greyboxaudio/Purrtico-M/README.md

# Purrtico-M
 
Based on the AMEK MZ-15-RN Equalizer
