greyboxaudio/Purrtico-M/Purrtico_M.pdf

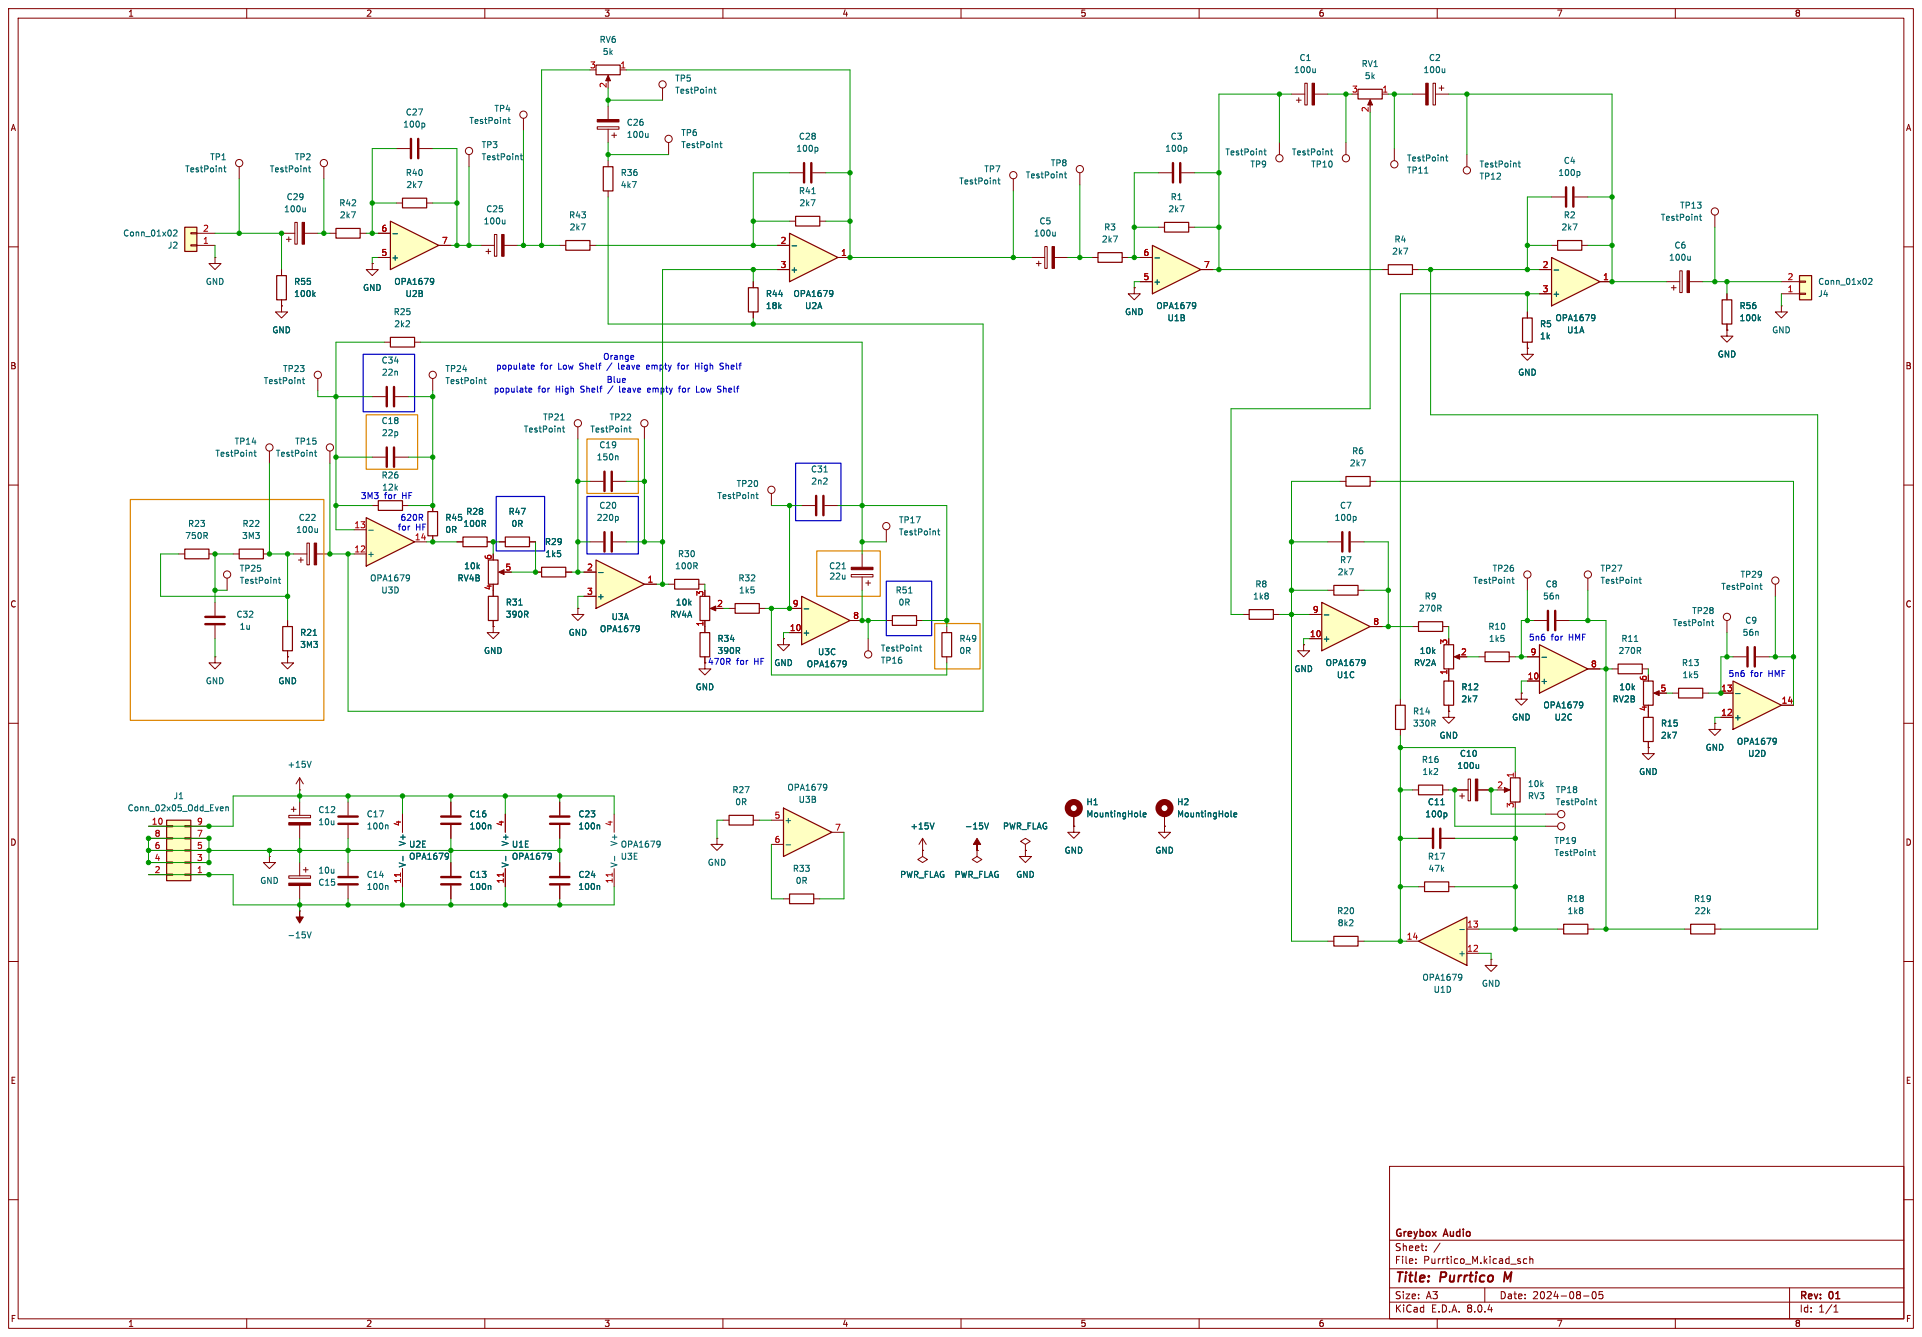
[picture p1: page 1]
