greyboxaudio/Purrtico-M/Simulation/purrtico_m.asc

C1: cap; 100p
C2: cap; 100µ
C3: cap; 100µ
C4: cap; 5n6
C5: cap; 5n6
C6: cap; 150n
C7: cap; 22p
C8: cap; 1µ
C9: polcap; 22µ; V=16 Irms=2.88675 Rser=0.03 Lser=0 mfg="KEMET" pn="A700D226M016ATE030" type="Al electrolytic"
C10: cap; 100p
C11: cap; 100p
C12: polcap; 100µ; V=25 Irms=110m Rser=0.5543 Lser=3.868n mfg="Würth Elektronik" pn="865090449009 WCAP-ASLU 8x6,5" type="Al electrolytic"
C13: polcap; 100µ; V=25 Irms=110m Rser=0.5543 Lser=3.868n mfg="Würth Elektronik" pn="865090449009 WCAP-ASLU 8x6,5" type="Al electrolytic"
C14: polcap; 100µ; V=25 Irms=110m Rser=0.5543 Lser=3.868n mfg="Würth Elektronik" pn="865090449009 WCAP-ASLU 8x6,5" type="Al electrolytic"
C15: polcap; 100µ; V=25 Irms=110m Rser=0.5543 Lser=3.868n mfg="Würth Elektronik" pn="865090449009 WCAP-ASLU 8x6,5" type="Al electrolytic"
C16: polcap; 100µ; V=25 Irms=110m Rser=0.5543 Lser=3.868n mfg="Würth Elektronik" pn="865090449009 WCAP-ASLU 8x6,5" type="Al electrolytic"
C17: polcap; 100µ; V=35 Irms=414m Rser=0.18 Lser=3.3n mfg="Würth Elektronik" pn="860160574013 WCAP-ATLL 8x11,5" type="Al electrolytic"
C18: cap; 100p
C19: cap; 100p
C20: cap; 220p
C21: cap; 22n
C22: cap; 100p
C23: cap; 100p
C24: cap; 100µ
C25: cap; 100µ
C26: cap; 100p
C27: cap; 100p
C28: cap; 100µ
C29: cap; 100µ
C30: cap; 56n
C31: cap; 56n
C32: cap; 100p
C33: cap; 100p
C34: cap; 100µ
C35: cap; 100µ
C36: cap; 100p
C67: cap; 2n2
C68: polcap; 100µ; V=35 Irms=414m Rser=0.18 Lser=3.3n mfg="Würth Elektronik" pn="860160574013 WCAP-ATLL 8x11,5" type="Al electrolytic"
C69: polcap; 100µ; V=35 Irms=414m Rser=0.18 Lser=3.3n mfg="Würth Elektronik" pn="860160574013 WCAP-ATLL 8x11,5" type="Al electrolytic"
C70: polcap; 100µ; V=35 Irms=414m Rser=0.18 Lser=3.3n mfg="Würth Elektronik" pn="860160574013 WCAP-ATLL 8x11,5" type="Al electrolytic"
R1: res; 2k7
R2: res; 2k7
R3: res; 1k8
R4: res; 1k
R5: res; 270
R6: res; 1k5
R7: res; 1k5
R8: res; 2k2
R9: res; 12k
R10: res; 2k7
R11: res; 2k7
R12: res; 100
R13: res; 2k7
R14: res; 1k5
R15: res; 100
R16: res; 390
R17: res; 1k5
R18: res; 390
R19: res; 3Meg3
R20: res; 750
R21: res; 3Meg3
R22: res; 2k7
R23: res; 2k7
R24: res; 2k7
R25: res; 2k7
R26: res; 4k7
R27: res; 18k
R28: res; 2k7
R29: res; 2k7
R30: res; 47k
R31: res; 1k8
R32: res; 8k2
R33: res; 22k
R34: res; 2k7
R35: res; 1k8
R36: res; 1k
R37: res; 1k5
R38: res; 2k7
R39: res; 1k5
R40: res; 2k7
R41: res; 47k
R42: res; 1k8
R43: res; 8k2
R44: res; 22k
R45: res; 1k2
R46: res; 330
R47: res; 2k7
R48: res; 2k7
R49: res; 270
R50: res; 270
R51: res; 2k7
R52: res; 2k7
R74: res; 1k2
R75: res; 330
R76: res; 2k7
R77: res; 2k7
R78: res; 270
R115: res; 2k7
R116: res; 2k7
R117: res; 2k7
R118: res; 2k7
R119: res; 4k7
R120: res; 18k
R121: res; 1k5
R122: res; 2k2
R123: res; 3Meg3
R124: res; 100
R125: res; 100
R126: res; 1k5
R127: res; 470
R128: res; 620
U1: ADTL082
U4: ADTL082
U9: ADTL082
U10: ADTL082
U11: ADTL082
U12: ADTL082
U13: ADTL082
U14: ADTL082
U15: ADTL082
U16: ADTL082
U17: ADTL082
U18: ADTL082
U19: ADTL082
U20: ADTL082
U21: ADTL082
U22: ADTL082
U23: ADTL082
U32: ADTL082
U33: ADTL082
U34: ADTL082
U35: ADTL082
U36: ADTL082
V1: voltage; 15
V2: voltage; -15
V3: voltage; SINE(0 1 1000 0 0 0 1000); AC 1
VR1: res; {G1}
VR2: res; {G2}
VR3: res; {M1F1}
VR4: res; {M1F2}
VR5: res; {M1F1}
VR6: res; {M1F2}
VR7: res; {G1}
VR8: res; {G2}
VR9: res; {M2F1}
VR10: res; {Q1}
VR11: res; {M2F2}
VR12: res; {M2F1}
VR13: res; {M2F2}
VR14: res; {Q1}
VR15: res; {Q2}
VR16: res; {G2}
VR17: res; {G1}
VR18: res; {LFF1}
VR19: res; {LFF2}
VR20: res; {LFF1}
VR21: res; {LFF2}
VR22: res; {Q2}
VR31: res; {HFF1}
VR32: res; {HFF2}
VR33: res; {HFF1}
VR34: res; {HFF2}
VR35: res; {G1}
VR36: res; {G2}
Named nets: 0, V+, V-, HF, LF2, HMF, LMF2
.param G1=5k G2=1
.ac dec 101 10 100k
.step param Rx1 list 1 2
.param HFF1 table(Rx1,1,10k,2,1)
.param HFF2=table(Rx1,1,1,2,10k)
.param M1F1 table(Rx1,1,10k,2,1)
.param M1F2=table(Rx1,1,1,2,10k)
.param M2F1 table(Rx1,1,10k,2,1)
.param M2F2=table(Rx1,1,1,2,10k)
.param LFF1 table(Rx1,1,10k,2,1)
.param LFF2=table(Rx1,1,1,2,10k)
.param Q1=5k Q2=5k
