greyboxaudio/Purrtico-M/Purrtico_M.kicad_pcb

## KiCad design Purrtico_M.kicad_pcb (2024-08-16)

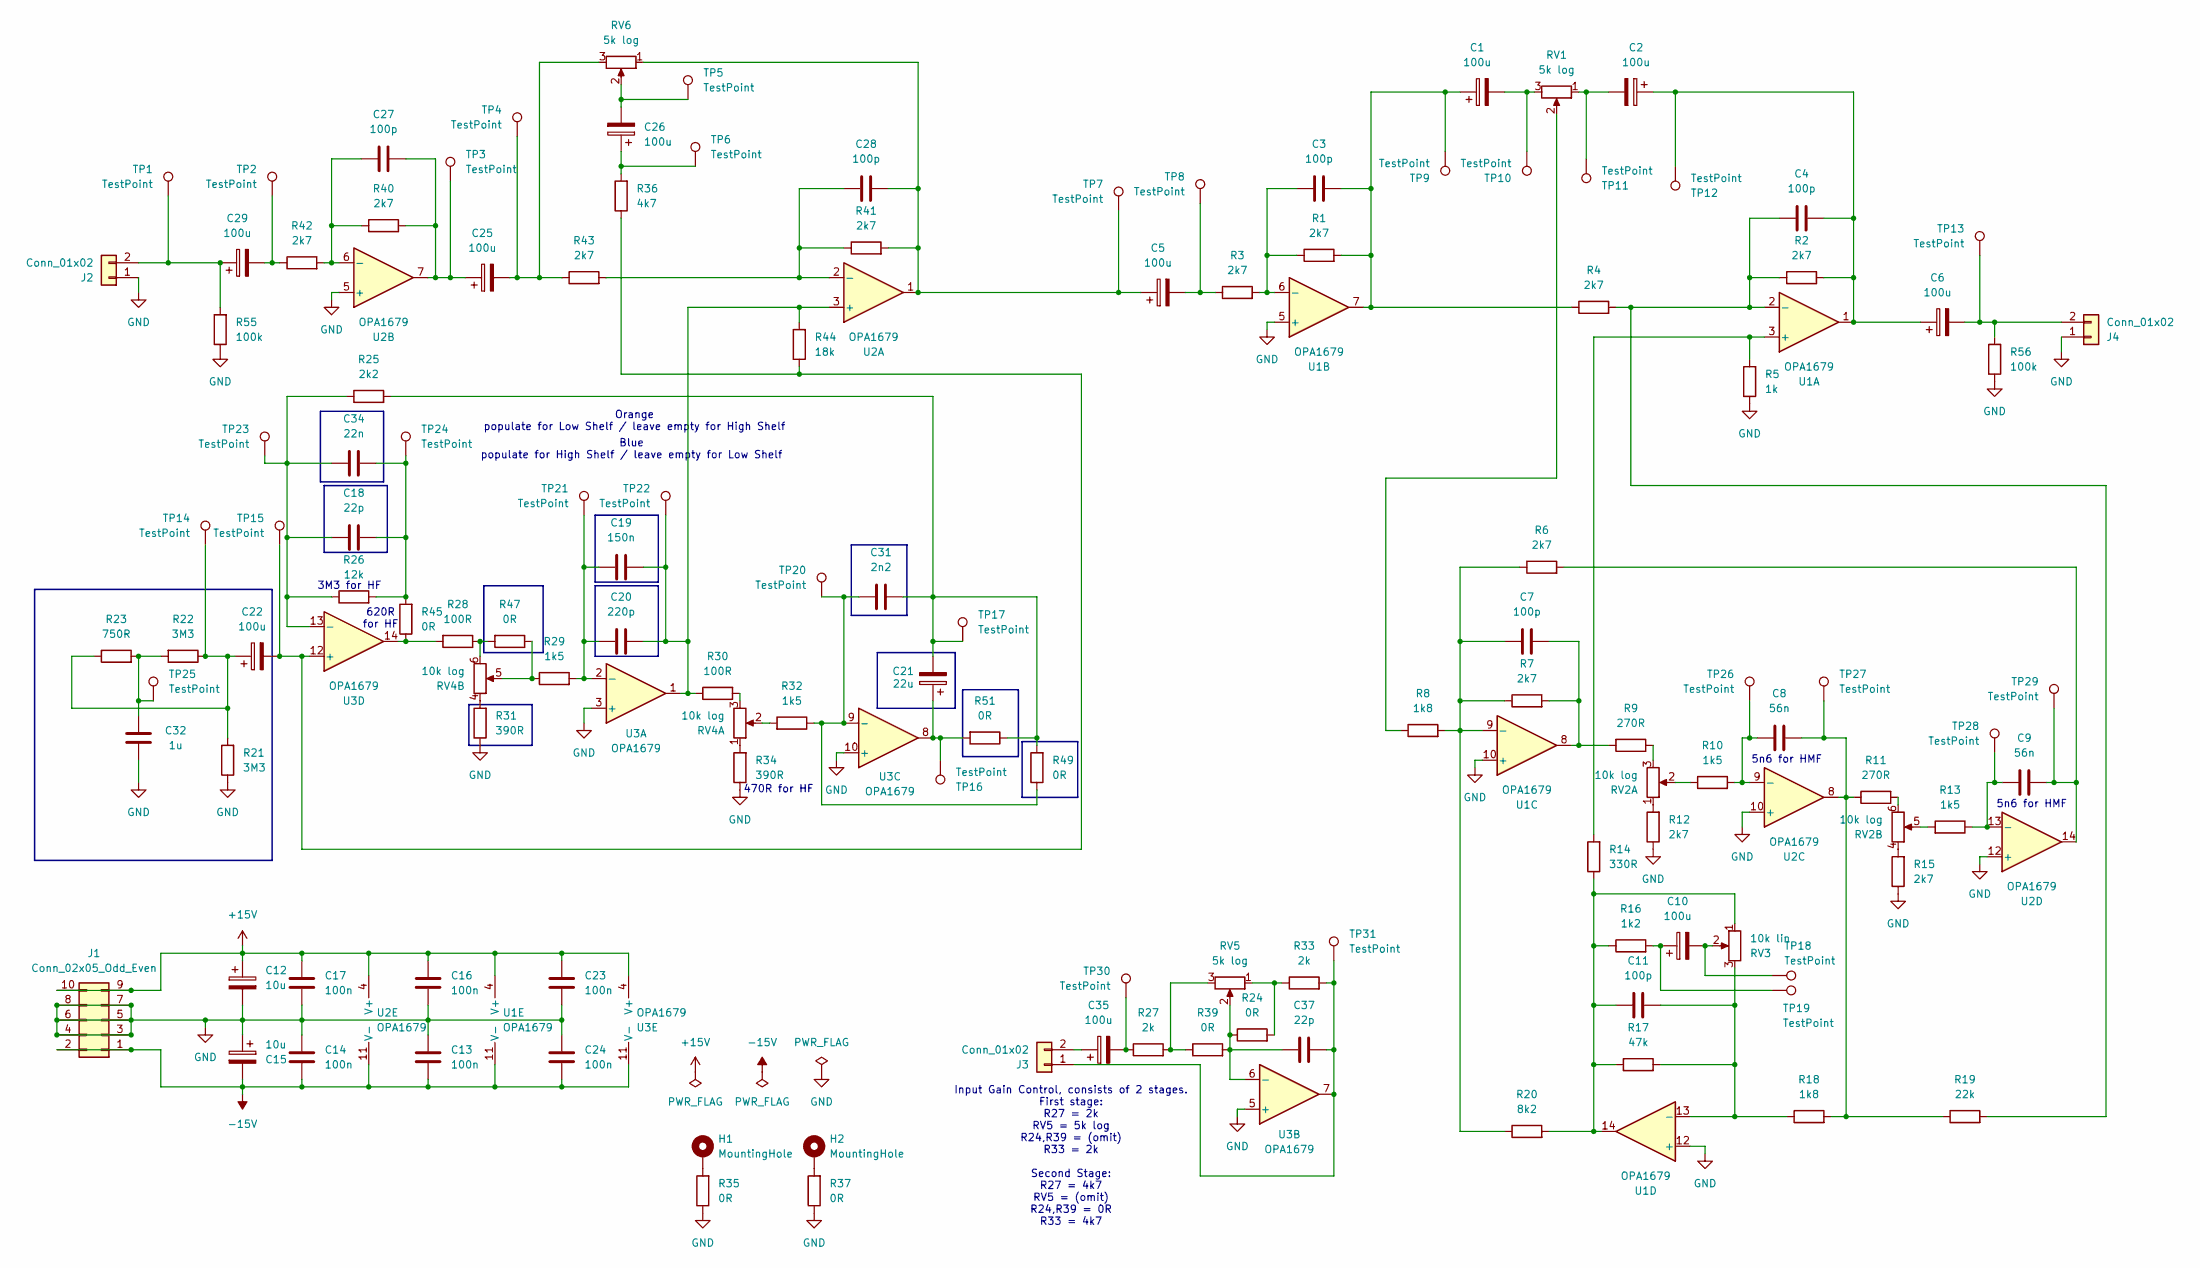
[picture p2: schematic Purrtico_M.kicad_sch, Purrtico M]

Parts:
C1, C2, C5, C6, C10, C22, C25, C26, C29, C35: 100u; CP_Radial_D6.3mm_P2.50mm
C3, C4, C7, C11, C27, C28: 100p; C_1206_3216Metric
C8, C9: 56n; C_Rect_L7.2mm_W2.5mm_P5.00mm_FKS2_FKP2_MKS2_MKP2
C12, C15: 10u; CP_Radial_D6.3mm_P2.50mm
C13, C14, C16, C17, C23, C24: 100n; C_1206_3216Metric
C18, C37: 22p; C_1206_3216Metric
C19: 150n; C_Rect_L7.2mm_W2.5mm_P5.00mm_FKS2_FKP2_MKS2_MKP2
C20: 220p; C_1206_3216Metric
C21: 22u; CP_Radial_D6.3mm_P2.50mm
C31: 2n2; C_Rect_L7.2mm_W2.5mm_P5.00mm_FKS2_FKP2_MKS2_MKP2
C32: 1u; C_Rect_L7.2mm_W2.5mm_P5.00mm_FKS2_FKP2_MKS2_MKP2
C34: 22n; C_Rect_L7.2mm_W2.5mm_P5.00mm_FKS2_FKP2_MKS2_MKP2
H1, H2: MountingHole; MountingHole_3.2mm_M3_DIN965_Pad
J1: Conn_02x05_Odd_Even; PinHeader_2x05_P2.54mm_Vertical
J2, J3, J4: Conn_01x02; PinHeader_1x02_P2.54mm_Vertical
R1, R2, R3, R4, R6, R7, R12, R15, R40, R41, R42, R43: 2k7; R_1206_3216Metric
R5: 1k; R_1206_3216Metric
R8, R18: 1k8; R_1206_3216Metric
R9, R11: 270R; R_1206_3216Metric
R10, R13, R29, R32: 1k5; R_1206_3216Metric
R14: 330R; R_1206_3216Metric
R16: 1k2; R_1206_3216Metric
R17: 47k; R_1206_3216Metric
R19: 22k; R_1206_3216Metric
R20: 8k2; R_1206_3216Metric
R21, R22: 3M3; R_1206_3216Metric
R23: 750R; R_1206_3216Metric
R24, R35, R37, R39, R45, R47, R49, R51: 0R; R_1206_3216Metric
R25: 2k2; R_1206_3216Metric
R26: 12k; R_1206_3216Metric
R27, R33: 2k; R_1206_3216Metric
R28, R30: 100R; R_1206_3216Metric
R31, R34: 390R; R_1206_3216Metric
R36: 4k7; R_1206_3216Metric
R44: 18k; R_1206_3216Metric
R55, R56: 100k; R_1206_3216Metric
RV1, RV5, RV6: 5k log; PinHeader_1x03_P2.54mm_Vertical
RV2, RV4: 10k log; PinHeader_2x03_P2.54mm_Vertical
RV3: 10k lin; PinHeader_1x03_P2.54mm_Vertical
TP1, TP2, TP3, TP4, TP5, TP6, TP7, TP8, TP9, TP10, TP11, TP12, TP13, TP14, TP15, TP16, TP17, TP18, TP19, TP20, TP21, TP22, TP23, TP24, TP25, TP26, TP27, TP28, TP29, TP30, TP31: TestPoint; TestPoint_THTPad_D1.0mm_Drill0.5mm
U1, U2, U3: OPA1679; SOIC-14_3.9x8.7mm_P1.27mm

Connections:
+15V: C12.1, C16.2, C17.2, C23.2, J1.9, J1.10, U1.4 (V+), U2.4 (V+), U3.4 (V+)
-15V: C13.1, C14.1, C15.2, C24.1, J1.1, J1.2, U1.11 (V-), U2.11 (V-), U3.11 (V-)
GND: C12.2, C13.2, C14.2, C15.1, C16.1, C17.1, C23.1, C24.2, C32.2, J1.3, J1.4, J1.5, J1.6, J1.7, J1.8, J2.1, J4.1, R5.1, R12.1, R15.1, R21.1, R31.1, R34.1, R35.1, R37.1, R55.1, R56.1, U1.5 (+), U1.10 (+), U1.12 (+), U2.5 (+), U2.10 (+), U2.12 (+), U3.3 (+), U3.5 (+), U3.10 (+)
unnamed: C1.1, C3.2, R1.2, R4.1, TP9.1, U1.7
unnamed: C1.2, RV1.3, TP10.1
unnamed: C2.1, C4.2, C6.1, R2.2, TP12.1, U1.1
unnamed: C2.2, RV1.1, TP11.1
unnamed: C5.2, R3.1, TP8.1
unnamed: C7.2, R7.2, R9.2, U1.8
unnamed: C8.2, R11.1, R18.2, R19.1, TP27.1, U2.8
unnamed: C9.2, R6.2, TP29.1, U2.14
unnamed: C10.1, R16.2, TP19.1
unnamed: C10.2, RV3.2, TP18.1
unnamed: C11.1, R14.1, R16.1, R17.1, R20.2, RV3.1, U1.14
unnamed: C18.2, C34.2, R26.2, R45.2, TP24.1
unnamed: C21.1, R51.2, TP16.1, U3.8
unnamed: C21.2, C31.2, R25.2, R49.2, R51.1, TP17.1
unnamed: C22.1, R21.2, R22.1, R23.1, TP14.1
unnamed: C25.1, C27.2, R40.2, TP3.1, U2.7
unnamed: C25.2, R43.1, RV6.3, TP4.1
unnamed: C26.1, R36.2, TP6.1
unnamed: C26.2, RV6.2, TP5.1
unnamed: C5.1, C28.2, R41.2, RV6.1, TP7.1, U2.1
unnamed: C29.2, R42.1, TP2.1
unnamed: C32.1, R22.2, R23.2, TP25.1
unnamed: C35.2, R27.1, TP30.1
unnamed: H1.1, R35.2
unnamed: H2.1, R37.2
unnamed: C29.1, J2.2, R55.2, TP1.1
unnamed: C37.1, J3.1, R33.2, TP31.1, U3.7
unnamed: C35.1, J3.2
unnamed: C6.2, J4.2, R56.2, TP13.1
unnamed: R8.1, RV1.2
unnamed: R9.1, RV2.3
unnamed: R10.1, RV2.2
unnamed: R11.2, RV2.6
unnamed: R12.2, RV2.1
unnamed: R13.2, RV2.5
unnamed: R15.2, RV2.4
unnamed: R24.2, R33.1, RV5.1
unnamed: R27.2, R39.1, RV5.3
unnamed: R28.1, R47.2, RV4.6
unnamed: R28.2, R45.1, U3.14
unnamed: R29.1, R47.1, RV4.5
unnamed: R30.2, RV4.3
unnamed: R31.2, RV4.4
unnamed: R32.2, RV4.2
unnamed: R34.2, RV4.1
unnamed: R5.2, R14.2, U1.3 (+)
unnamed: C4.1, R2.1, R4.2, R19.2, U1.2 (-)
unnamed: C3.1, R1.1, R3.2, U1.6 (-)
unnamed: C7.1, R6.1, R7.1, R8.2, R20.1, U1.9 (-)
unnamed: C11.2, R17.2, R18.1, RV3.3, U1.13 (-)
unnamed: C19.2, C20.2, R30.1, R44.2, TP22.1, U2.3 (+), U3.1
unnamed: C28.1, R41.1, R43.2, U2.2 (-)
unnamed: C27.1, R40.1, R42.2, U2.6 (-)
unnamed: C8.1, R10.2, TP26.1, U2.9 (-)
unnamed: C9.1, R13.1, TP28.1, U2.13 (-)
unnamed: C19.1, C20.1, R29.2, TP21.1, U3.2 (-)
unnamed: C37.2, R24.1, R39.2, RV5.2, U3.6 (-)
unnamed: C31.1, R32.1, R49.1, TP20.1, U3.9 (-)
unnamed: C22.2, R36.1, R44.1, TP15.1, U3.12 (+)
unnamed: C18.1, C34.1, R25.1, R26.1, TP23.1, U3.13 (-)

Notes on the sheet:
5n6 for HMF
470R for HF
Input Gain Control, consists of 2 stages. First stage: R27 = 2k RV5 = 5k log R24,R39 = (omit) R33 = 2k Second Stage: R27 = 4k7 RV5 = (omit) R24,R39 = 0R R33 = 4k7
3M3 for HF
620R for HF
Orange populate for Low Shelf / leave empty for High Shelf
Blue populate for High Shelf / leave empty for Low Shelf

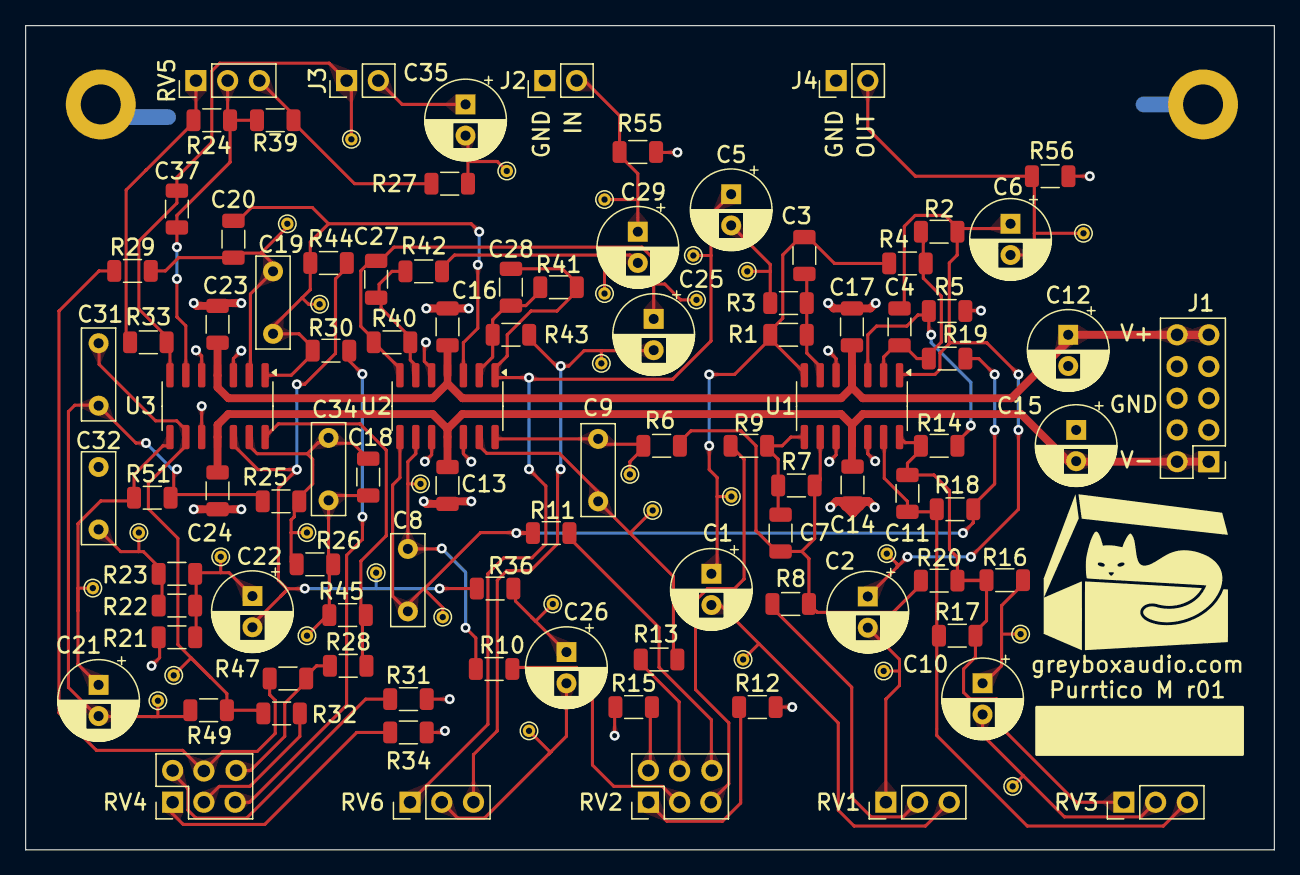
[picture p3: board Purrtico_M.kicad_pcb from above]

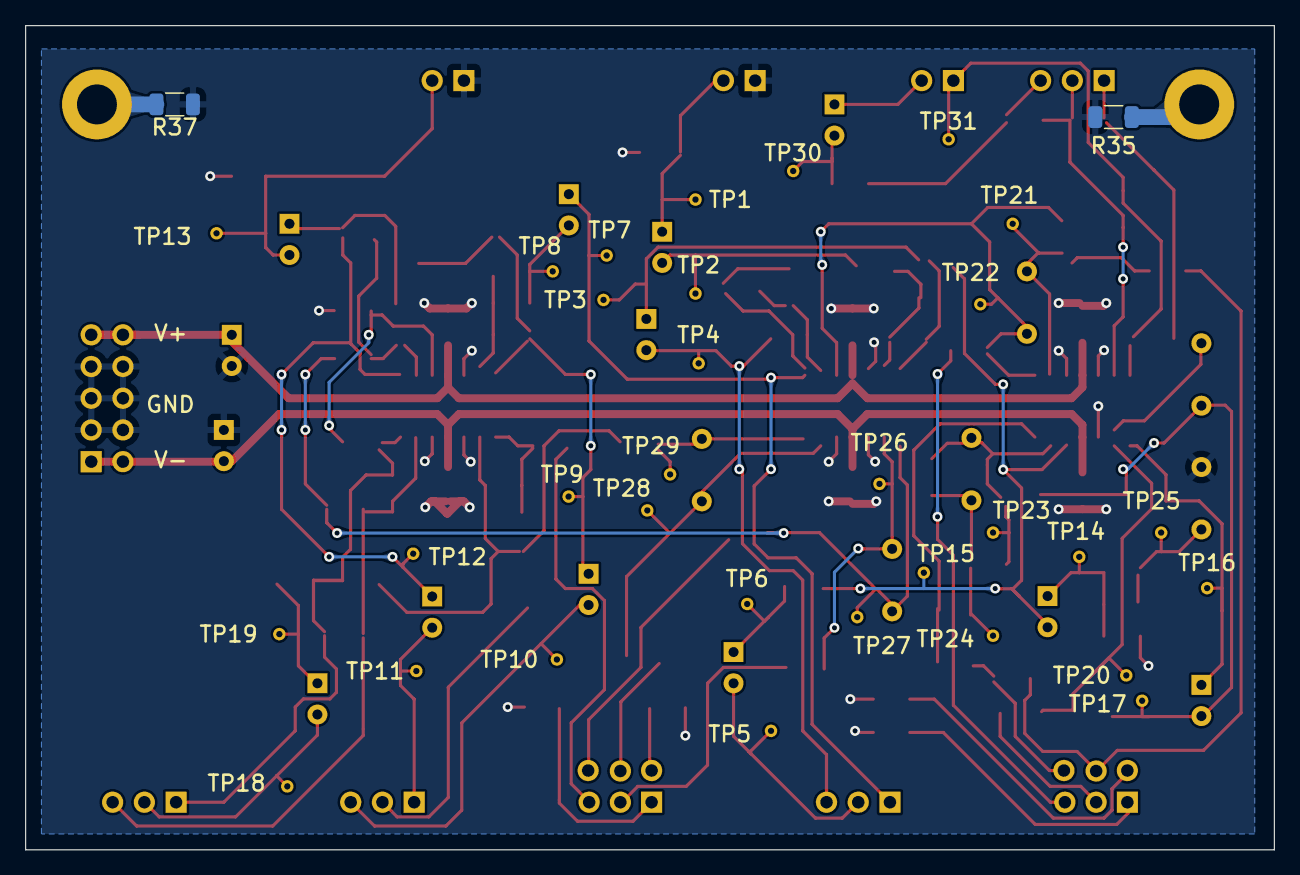
[picture p4: board Purrtico_M.kicad_pcb from below]

Board: 2 copper layers, 100.0 x 66.0 mm, 129 parts (2 on the bottom side), 63 nets.
