greyboxaudio/Purrtico-M/(commit log)

2024-07-18 started pcb
    [Purrtico_M.kicad_pcb, Purrtico_M.kicad_sch]
2024-07-18 update pcb
    [Purrtico_M.kicad_pcb]
2024-07-19 all connected
    [Purrtico_M.kicad_pcb]
2024-07-20 update routing
    [Purrtico_M.kicad_pcb, Purrtico_M.kicad_sch]
2024-07-21 added shelving band
    [Purrtico_M.csv, Purrtico_M.kicad_pcb, Purrtico_M.kicad_sch]
2024-07-21 modified shelving filter
    [Purrtico_M.kicad_pcb, Purrtico_M.kicad_sch]
2024-07-22 everything's routed
    [Purrtico_M.kicad_pcb]
2024-07-23 changed pcb size
    [Purrtico_M.kicad_pcb, Purrtico_M.kicad_sch]
2024-07-24 refine layout
    [Purrtico_M.kicad_pcb]
2024-07-24 added tespoints
    [Purrtico_M.kicad_pcb, Purrtico_M.kicad_sch]
2024-07-24 flipped text on backside
    [Purrtico_M.kicad_pcb]
2024-07-30 first update after testing
    shelving circuit not working for whatever reason :/
    [Purrtico_M.kicad_pcb, Purrtico_M.kicad_sch]
2024-07-30 add pdf
    [Purrtico_M.csv]
2024-07-31 update schematic
    [Purrtico_M.kicad_pcb, Purrtico_M.kicad_sch]
2024-08-01 update pcb
    added 470p cap as MLCC, removed two mounting holes to create space for wider potentiometer spacing, swapped rows of RV6 to enable the use of a single gang potentiometer for the high shelf
    [Purrtico_M.kicad_pcb, Purrtico_M.kicad_sch]
2024-08-02 update pcb
    swapped potentiometer pinouts, increased potentiometer spacing on pcb
    [Purrtico_M.kicad_pcb, Purrtico_M.kicad_sch]
2024-08-02 clean up pcb
    [Purrtico_M.kicad_pcb, Purrtico_M.kicad_sch]
2024-08-03 tweak LF EQ
    [Purrtico_M.kicad_pcb, Purrtico_M.kicad_sch]
2024-08-05 tuned low shelf
    tuned the low shelf so that it closely matches the 5033
    [Purrtico_M.kicad_pcb, Purrtico_M.kicad_sch]
2024-08-05 update high shelf
    [Purrtico_M.kicad_pcb, Purrtico_M.kicad_sch]
2024-08-06 added input gain control
    [Purrtico_M.kicad_pcb, Purrtico_M.kicad_sch]
2024-08-14 added 0R for mounting holes
    as well as some small layout refinements
    [Purrtico_M.kicad_pcb, Purrtico_M.kicad_sch]
2024-08-15 update potentiometer values
    [Purrtico_M.kicad_pcb, Purrtico_M.kicad_sch]
2024-08-16 added gerber files
    [Purrtico_M-B_Cu.gbl, Purrtico_M-B_Mask.gbs, Purrtico_M-B_Paste.gbp, Purrtico_M-B_Silkscreen.gbo, Purrtico_M-Edge_Cuts.gm1, Purrtico_M-F_Cu.gtl, Purrtico_M-F_Mask.gts, Purrtico_M-F_Paste.gtp]
2025-01-19 updated comments
    [Purrtico_M.kicad_sch]
